05ChaRles09/RV32I-5Stage-Pipeline-CPU/docs/IP_PACKAGING_LESSONS.md

# IP 打包踩雷紀錄（Vivado 2022.2）

| 症狀 | 原因 | 解法 |
|---|---|---|
| module not found / 檔案找不到 | `component.xml` 的路徑指向 `../src` | 改為 IP 內的 `hdl/` 相對路徑 |
| 檔案被當成 Verilog Header | `.v` 項目帶有 `isIncludeFile` | 移除該屬性後 Re-Package |
| 重複模組 / 舊程式被用到 | edit project 的 `imports` 有舊副本、舊 repository 路徑 | 刪除舊 imports 與舊 IP repo 路徑，重新 Refresh |
| Customization Parameters / Addressing 是空的 | 打包時頂層參數沒被辨識 | 頂層選對、Merge changes 後重新辨識 |
| `C_S00_AXI_ADDR_WIDTH = 4` | 預設值未改 | 設為 6（暫存器到 0x2C） |
| Merge changes 無限循環（19-377） | 重複檔案／參數不一致 | 清乾淨資料夾重打包 |
| 改了 RTL 卻沒生效 | OOC synthesis / ipshared 快取 | Reset output products → Generate（Global） |
| 板上讀值全 0 / Overlay 不符 | `.bit` 與 `.hwh` 不成對，或 kernel 沒重啟 | 同一次 build 的檔案、重啟 kernel |
| BD 嚴重警告 BD 41-759（`*_bram_dout` 未連接） | CPU IP 的 BRAM 介面沒有接到 BMG | 把 `IMEM_BRAM`／`DMEM_BRAM` 接到 BMG 的 `BRAM_PORTB` |
| BD 41-237（`MASTER_TYPE` 不一致） | BMG 在 BRAM Controller 模式，介面型別是 `BRAM_CTRL`，自訂 IP 的介面是 `OTHER` | 提示性警告，不影響功能；不值得為此重新打包 |
| BMG 的 Load Init File 灰色、Write Depth 改不動 | BRAM Controller 模式下初始化檔被鎖住、深度由 controller 位址範圍推導 | 需要 COE 或固定深度時改用 Stand Alone 模式 |
| 修改 BMG 後 Address Editor 的位址被重設 | Validate／重新產生時 Vivado 會重新分配位址 | 重設位址後用 Tcl 檢查 `get_bd_addr_segs` |
| PS 批次寫入 IMEM 後 word 0 被改掉 | BMG 的 Enable Port Type 設成 Always Enabled，ENA 腳位消失 | 改成 Use ENA Pin／Use ENB Pin（見開發紀錄 Bug 11） |
