05ChaRles09/RV32I-5Stage-Pipeline-CPU/RV32I Five-Stage Pipelined CPU｜專題成果.pdf

# Five-Stage Pipelined CPU

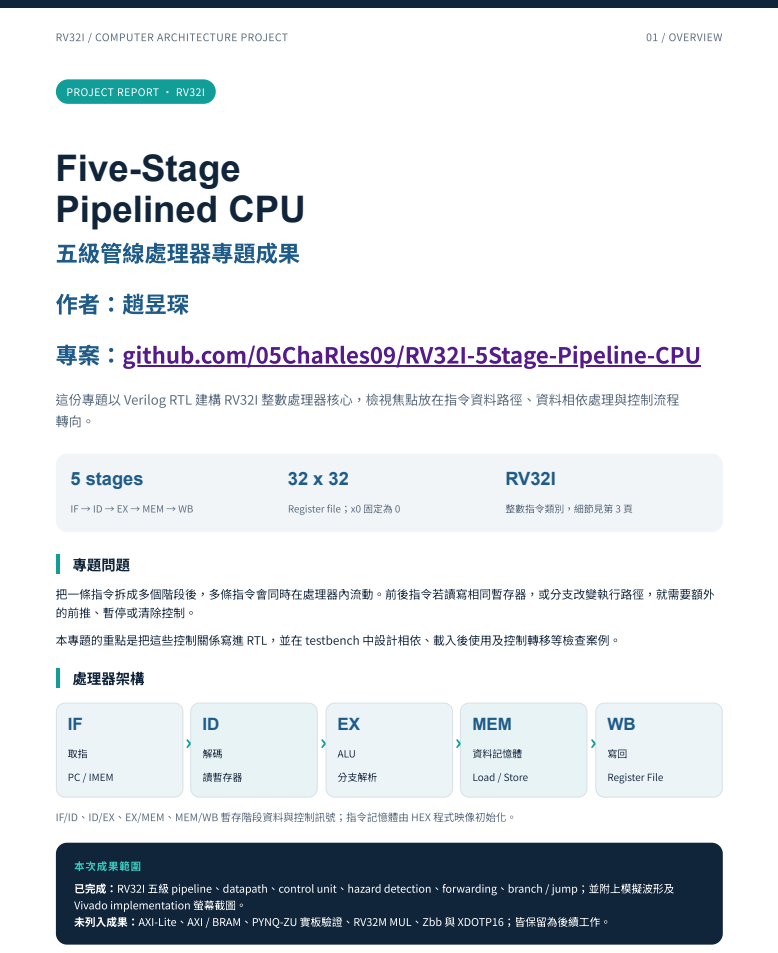
[picture p13: page 1]
PROJECT REPORT · RV32I; 五級管線處理器專題成果; 作者：趙昱琛; 5 stages; 整數指令類別，細節見第 3 頁; 專題問題; 處理器架構; RV32I / COMPUTER ARCHITECTURE PROJECT; 01 / OVERVIEW; PC / IMEM; 讀暫存器; ALU; 分支解析; MEM; 資料記憶體; Load / Store; Register File

專案：github.com/05ChaRles09/RV32I-5Stage-Pipeline-CPU

這份專題以 Verilog RTL 建構 RV32I 整數處理器核心，檢視焦點放在指令資料路徑、資料相依處理與控制流程

IF → ID → EX → MEM → WB

Register file；x0 固定為 0

把一條指令拆成多個階段後，多條指令會同時在處理器內流動。前後指令若讀寫相同暫存器，或分支改變執行路徑，就需要額外
的前推、暫停或清除控制。

本專題的重點是把這些控制關係寫進 RTL，並在 testbench 中設計相依、載入後使用及控制轉移等檢查案例。

IF/ID、ID/EX、EX/MEM、MEM/WB 暫存階段資料與控制訊號；指令記憶體由 HEX 程式映像初始化。

本次成果範圍
已完成：RV32I 五級 pipeline、datapath、control unit、hazard detection、forwarding、branch / jump；並附上模擬波形及
Vivado implementation 螢幕截圖。
未列入成果：AXI-Lite、AXI / BRAM、PYNQ-ZU 實板驗證、RV32M MUL、Zbb 與 XDOTP16；皆保留為後續工作。

# 資料流與冒險處理

IF

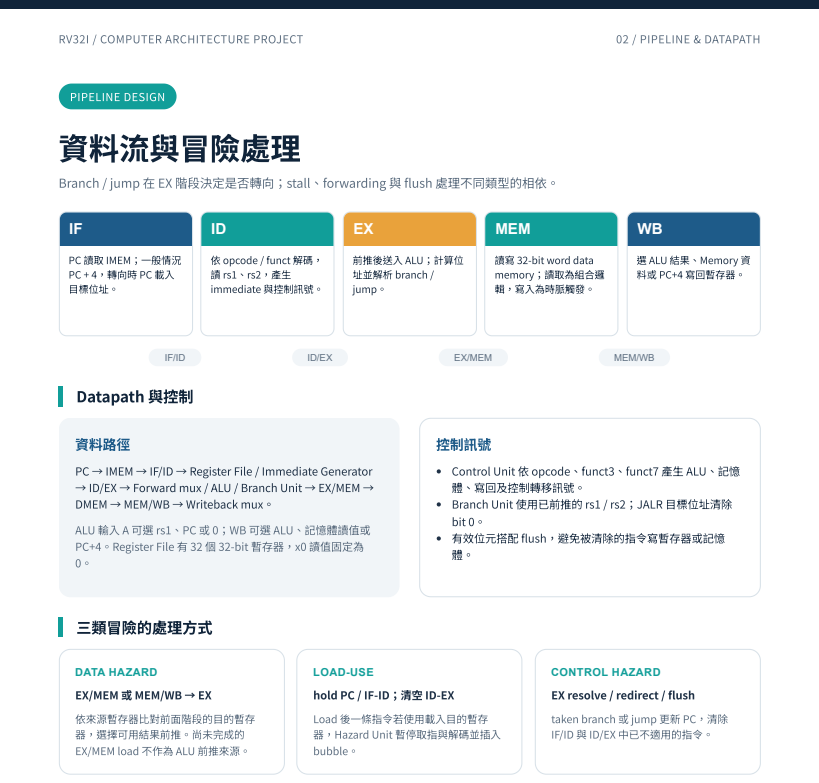
[picture p14: page 2]
PIPELINE DESIGN; MEM; EX/MEM; MEM/WB; Datapath 與控制; 資料路徑; 控制訊號; 三類冒險的處理方式; DATA HAZARD; LOAD-USE; CONTROL HAZARD; RV32I / COMPUTER ARCHITECTURE PROJECT; 02 / PIPELINE & DATAPATH

Branch / jump 在 EX 階段決定是否轉向；stall、forwarding 與 flush 處理不同類型的相依。

PC 讀取 IMEM；一般情況
PC + 4，轉向時 PC 載入
目標位址。

依 opcode / funct 解碼，
immediate 與控制訊號。

前推後送入 ALU；計算位
址並解析 branch /
jump。

讀寫 32-bit word data
memory；讀取為組合邏
輯，寫入為時脈觸發。

選 ALU 結果、Memory 資
料或 PC+4 寫回暫存器。

PC → IMEM → IF/ID → Register File / Immediate Generator
→ ID/EX → Forward mux / ALU / Branch Unit → EX/MEM →
DMEM → MEM/WB → Writeback mux。

Control Unit 依 opcode、funct3、funct7 產生 ALU、記憶
體、寫回及控制轉移訊號。
Branch Unit 使用已前推的 rs1 / rs2；JALR 目標位址清除
bit 0。
有效位元搭配 flush，避免被清除的指令寫暫存器或記憶

ALU 輸入 A 可選 rs1、PC 或 0；WB 可選 ALU、記憶體讀值或
PC+4。Register File 有 32 個 32-bit 暫存器，x0 讀值固定為

EX/MEM 或 MEM/WB → EX

hold PC / IF-ID；清空 ID-EX

EX resolve / redirect / flush

依來源暫存器比對前面階段的目的暫存
器，選擇可用結果前推。尚未完成的
EX/MEM load 不作為 ALU 前推來源。

Load 後一條指令若使用載入目的暫存
器，Hazard Unit 暫停取指與解碼並插入
bubble。

taken branch 或 jump 更新 PC，清除
IF/ID 與 ID/EX 中已不適用的指令。

RTL IMPLEMENTATION

# 實作範圍與測試設計

### RTL 可辨識的指令運算

指令類別 | RTL 中的解碼 / 運算 | 測試覆蓋狀況
R-type | ADD、SUB、AND、OR、XOR、SLL、SRL、SRA、SLT、SLTU | 主 testbench 有部分算術與相依案例
I-type ALU | ADDI、ANDI、ORI、XORI、SLLI、SRLI、SRAI、SLTI、SLTIU | opcode / funct 解碼寫於 Control Unit
Branch | BEQ、BNE、BLT、BGE、BLTU、BGEU | 另有 signed / unsigned branch 案例
Jump | JAL、JALR；link 資料為 PC+4 | 主 testbench 與 JALR 專用 testbench
Upper immediate | LUI、AUIPC | LUI 在主 testbench；AUIPC 在分支測試
Load / Store | opcode 層級 load/store；DMEM 以 32-bit word 索引 | 未見 byte / halfword lane、sign extension 選擇或 misalignment handling

## RTL 模組

rv32i_pipeline.v | 頂層 pipeline、PC 更新、stall / flush 接線與輸出觀察點。
control_unit / alu / imm_gen | opcode 控制、整數 ALU 與立即值產生。
forwarding / hazard / branch units | 運算元前推、load-use 偵測、分支及跳躍解析。
pipeline regs / regfile / memories | 階段暫存器、register file、HEX 指令記憶體與 word data memory。

## Testbench 設定的檢查案例

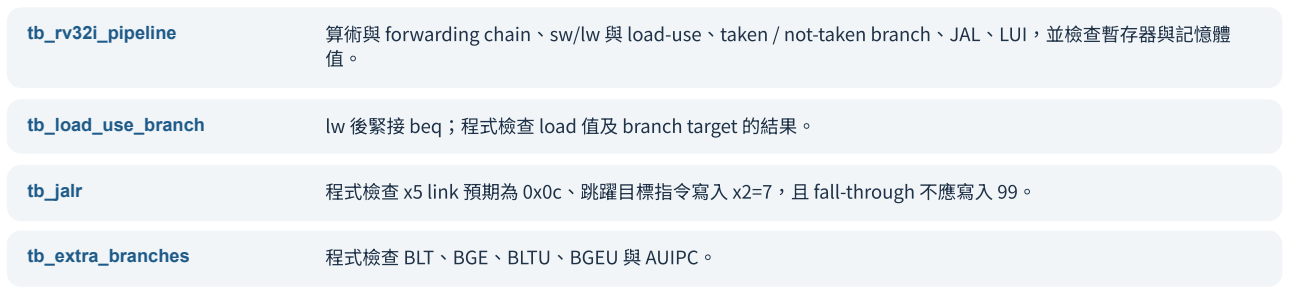
[picture p15: figure]
tb_extra_branches; 程式檢查 BLT、BGE、BLTU、BGEU 與 AUIPC。

tb_rv32i_pipeline | 算術與 forwarding chain、sw/lw 與 load-use、taken / not-taken branch、JAL、LUI，並檢查暫存器與記憶體
tb_load_use_branch | lw 後緊接 beq；程式檢查 load 值及 branch target 的結果。
tb_jalr | 程式檢查 x5 link 預期為 0x0c、跳躍目標指令寫入 x2=7，且 fall-through 不應寫入 99。
RV32I / COMPUTER ARCHITECTURE PROJECT | 03 / RTL & VERIFICATION

# 管線控制的波形 I

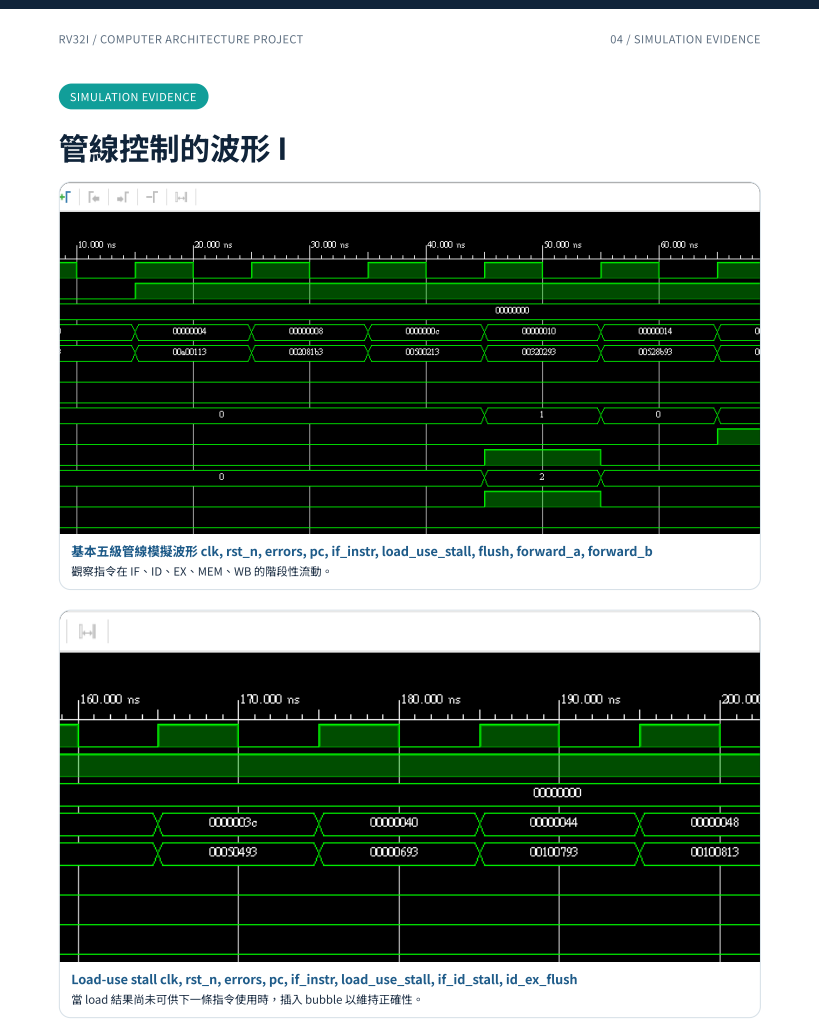
[picture p16: page 4]
SIMULATION EVIDENCE; RV32I / COMPUTER ARCHITECTURE PROJECT; 04 / SIMULATION EVIDENCE

基本五級管線模擬波形 clk, rst_n, errors, pc, if_instr, load_use_stall, flush, forward_a, forward_b
觀察指令在 IF、ID、EX、MEM、WB 的階段性流動。

Load-use stall clk, rst_n, errors, pc, if_instr, load_use_stall, if_id_stall, id_ex_flush
當 load 結果尚未可供下一條指令使用時，插入 bubble 以維持正確性。

# 管線控制的波形 II

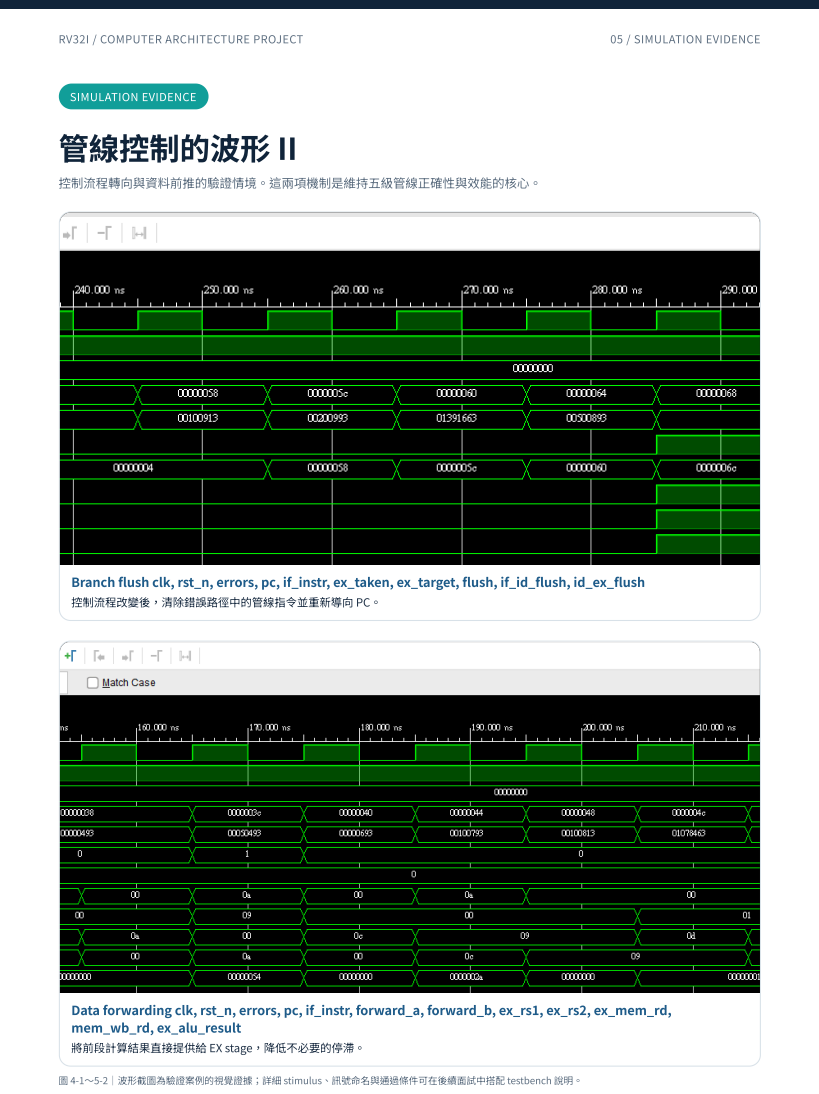
[picture p17: page 5]
SIMULATION EVIDENCE; 控制流程轉向與資料前推的驗證情境。這兩項機制是維持五級管線正確性與效能的核心。; RV32I / COMPUTER ARCHITECTURE PROJECT; 05 / SIMULATION EVIDENCE

Branch flush clk, rst_n, errors, pc, if_instr, ex_taken, ex_target, flush, if_id_flush, id_ex_flush
控制流程改變後，清除錯誤路徑中的管線指令並重新導向 PC。

Data forwarding clk, rst_n, errors, pc, if_instr, forward_a, forward_b, ex_rs1, ex_rs2, ex_mem_rd,
mem_wb_rd, ex_alu_result
將前段計算結果直接提供給 EX stage，降低不必要的停滯。

圖 4-1～5-2｜波形截圖為驗證案例的視覺證據；詳細 stimulus、訊號命名與通過條件可在後續面試中搭配 testbench 說明。

# FPGA 實作結果與延伸方向

4.560 ns

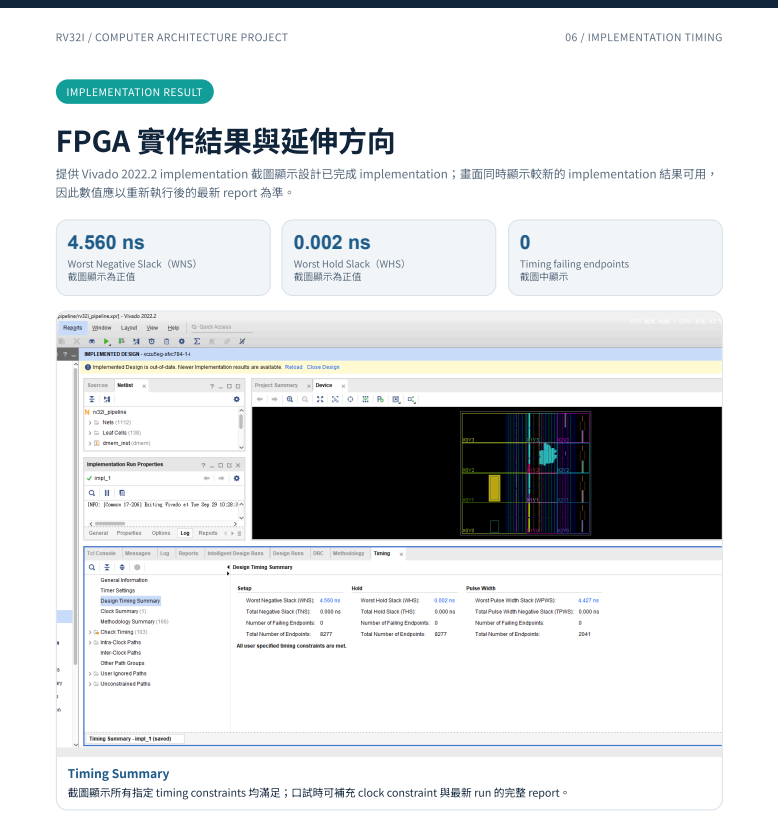
[picture p18: page 6]
IMPLEMENTATION RESULT; RV32I / COMPUTER ARCHITECTURE PROJECT; 06 / IMPLEMENTATION TIMING

提供 Vivado 2022.2 implementation 截圖顯示設計已完成 implementation；畫面同時顯示較新的 implementation 結果可用，
因此數值應以重新執行後的最新 report 為準。

Worst Negative Slack（WNS）
截圖顯示為正值

Worst Hold Slack（WHS）

Timing failing endpoints
截圖中顯示

Timing Summary
截圖顯示所有指定 timing constraints 均滿足；口試時可補充 clock constraint 與最新 run 的完整 report。

# 資源使用與延伸方向

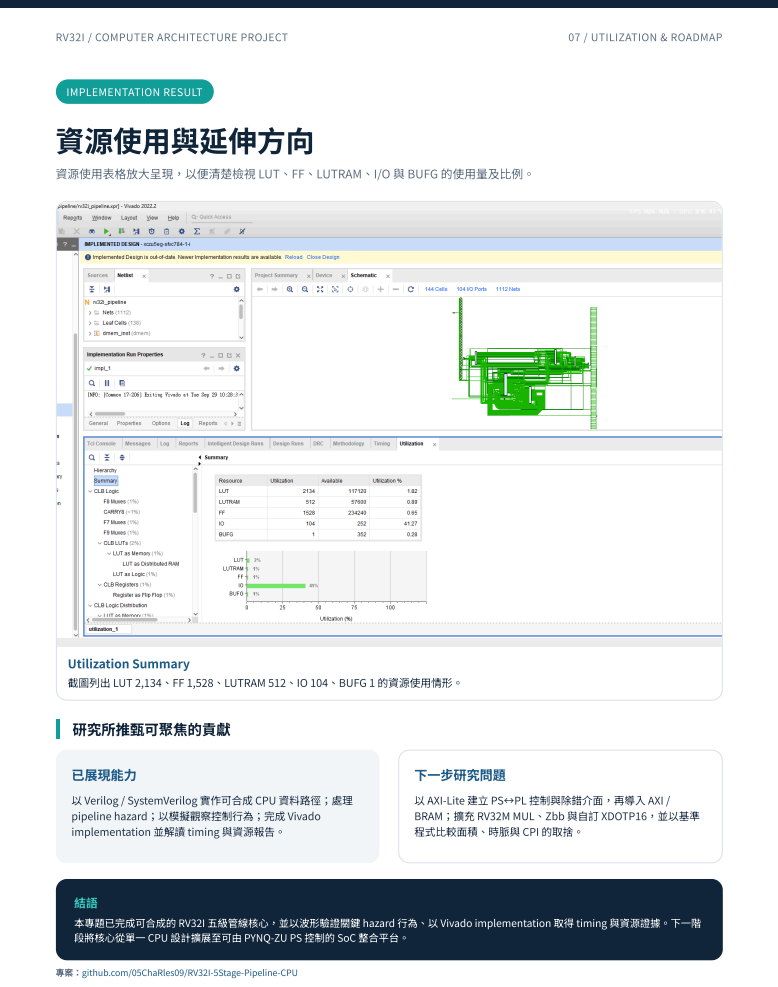
[picture p19: page 7]
IMPLEMENTATION RESULT; 研究所推甄可聚焦的貢獻; 已展現能力; 下一步研究問題; 段將核心從單一; CPU 設計擴展至可由 PYNQ-ZU PS 控制的 SoC 整合平台。; RV32I / COMPUTER ARCHITECTURE PROJECT; 07 / UTILIZATION & ROADMAP

資源使用表格放大呈現，以便清楚檢視 LUT、FF、LUTRAM、I/O 與 BUFG 的使用量及比例。

Utilization Summary
截圖列出 LUT 2,134、FF 1,528、LUTRAM 512、IO 104、BUFG 1 的資源使用情形。

以 Verilog / SystemVerilog 實作可合成 CPU 資料路徑；處理
pipeline hazard；以模擬觀察控制行為；完成 Vivado
implementation 並解讀 timing 與資源報告。

以 AXI-Lite 建立 PS↔PL 控制與除錯介面，再導入 AXI /
BRAM；擴充 RV32M MUL、Zbb 與自訂 XDOTP16，並以基準
程式比較面積、時脈與 CPI 的取捨。

本專題已完成可合成的 RV32I 五級管線核心，並以波形驗證關鍵 hazard 行為、以 Vivado implementation 取得 timing 與資源證據。下一階

專案：github.com/05ChaRles09/RV32I-5Stage-Pipeline-CPU
