05ChaRles09/RV32I-5Stage-Pipeline-CPU/src/imem.v

// imem.v instruction memory (BRAM-style): SYNCHRONOUS read, 1-cycle latency. Drive addr with pc_next so
// that instr is valid in the same cycle as the pc register (see rv32i_pipeline.v IF stage).
`timescale 1ns / 1ps

module imem #(
    parameter ADDR_WIDTH = 12,
    parameter MEM_FILE    = "program.hex",
    parameter EXTERNAL    = 0      // 1: instruction memory lives OUTSIDE (Block Memory Generator); ext_rdata is used
)(
    input  wire        clk,
    input  wire [31:0] addr,           // address of the instruction to appear on instr NEXT cycle
    output wire [31:0] instr,
    input  wire [31:0] ext_rdata       // read data of the external BRAM (only used when EXTERNAL=1)
);
    localparam DEPTH = (1 << ADDR_WIDTH);
    reg [31:0] mem [0:DEPTH-1];
    integer i;

    initial begin
        // Hardcoded default program (136 words) = board test program (RV32I + Zbb + MUL + XDOTP16 + illegal), generated by tools/gen_board_test.py.
        // This guarantees imem output is NON-CONSTANT even when the hex
        // file is absent (e.g. standalone Vivado synthesis where the run
        // directory has no program.hex) otherwise Vivado constant-folds
        // the whole ROM away and prunes the entire pipeline.
        // If $readmemh finds MEM_FILE, it overrides these values.
        for (i = 0; i < DEPTH; i = i + 1)
            mem[i] = 32'h00000013; // NOP fill FIRST, then the program words below overwrite it

        mem[0] = 32'h00500093;
        mem[1] = 32'h00a00113;
        mem[2] = 32'h002081b3;
        mem[3] = 32'h00500213;
        mem[4] = 32'h00320293;
        mem[5] = 32'h00528b93;
        mem[6] = 32'h00100313;
        mem[7] = 32'h00130393;
        mem[8] = 32'h00138413;
        mem[9] = 32'h00000593;
        mem[10] = 32'h02a00493;
        mem[11] = 32'h0095a023;
        mem[12] = 32'h0005a503;
        mem[13] = 32'h00950633;
        mem[14] = 32'h00000493;
        mem[15] = 32'h00050493;
        mem[16] = 32'h00000693;
        mem[17] = 32'h00100793;
        mem[18] = 32'h00100813;
        mem[19] = 32'h01078463;
        mem[20] = 32'h06300693;
        mem[21] = 32'h00700713;
        mem[22] = 32'h00100913;
        mem[23] = 32'h00200993;
        mem[24] = 32'h01391663;
        mem[25] = 32'h00500893;
        mem[26] = 32'h00900893;
        mem[27] = 32'h00900893;
        mem[28] = 32'h00000013;
        mem[29] = 32'h00000013;
        mem[30] = 32'h00000a93;
        mem[31] = 32'h00c000ef;
        mem[32] = 32'h00500a93;
        mem[33] = 32'h00700a93;
        mem[34] = 32'h06300a13;
        mem[35] = 32'h0080006f;
        mem[36] = 32'h00500a93;
        mem[37] = 32'h12345b37;
        mem[38] = 32'h0040006f;
        mem[39] = 32'hf0f090b7;
        mem[40] = 32'ha8108093;
        mem[41] = 32'h00ff0137;
        mem[42] = 32'h00310113;
        mem[43] = 32'h000121b7;
        mem[44] = 32'h30018193;
        mem[45] = 32'h4020f2b3;
        mem[46] = 32'h4020e333;
        mem[47] = 32'h4020c3b3;
        mem[48] = 32'h0a20c433;
        mem[49] = 32'h0a20d4b3;
        mem[50] = 32'h0a20e533;
        mem[51] = 32'h0a20f5b3;
        mem[52] = 32'h60209633;
        mem[53] = 32'h6020d6b3;
        mem[54] = 32'h60c0d713;
        mem[55] = 32'h60019793;
        mem[56] = 32'h60119813;
        mem[57] = 32'h60209893;
        mem[58] = 32'h60409913;
        mem[59] = 32'h60509993;
        mem[60] = 32'h0800ca33;
        mem[61] = 32'h6980da93;
        mem[62] = 32'h2871db13;
        mem[63] = 32'h60001b93;
        mem[64] = 32'h60101c13;
        mem[65] = 32'h60201c93;
        mem[66] = 32'h60009d13;
        mem[67] = 32'h60109d93;
        mem[68] = 32'h60019e13;
        mem[69] = 32'h01ce0eb3;
        mem[70] = 32'h6980df13;
        mem[71] = 32'h001f4fb3;
        mem[72] = 32'h01502423;
        mem[73] = 32'h00802283;
        mem[74] = 32'h00528333;
        mem[75] = 32'h60219393;
        mem[76] = 32'h00400413;
        mem[77] = 32'h00839463;
        mem[78] = 32'h05500493;
        mem[79] = 32'h00838463;
        mem[80] = 32'h02a50533;
        mem[81] = 32'h06600513;
        mem[82] = 32'h022087b3;
        mem[83] = 32'h02108833;
        mem[84] = 32'h020188b3;
        mem[85] = 32'hfff00993;
        mem[86] = 32'h03398a33;
        mem[87] = 32'h02398ab3;
        mem[88] = 32'h80000e37;
        mem[89] = 32'h00200e93;
        mem[90] = 32'h03de0f33;
        mem[91] = 32'h033e0fb3;
        mem[92] = 32'h02208b33;
        mem[93] = 32'h016b0bb3;
        mem[94] = 32'h036b0c33;
        mem[95] = 32'h01602623;
        mem[96] = 32'h00c02c83;
        mem[97] = 32'h023c8d33;
        mem[98] = 32'h03de83b3;
        mem[99] = 32'h00400413;
        mem[100] = 32'h00839463;
        mem[101] = 32'h03c00493;
        mem[102] = 32'h00838463;
        mem[103] = 32'h03de8db3;
        mem[104] = 32'h02b00513;
        mem[105] = 32'h0020878b;
        mem[106] = 32'h0010880b;
        mem[107] = 32'h0001888b;
        mem[108] = 32'h80008e37;
        mem[109] = 32'h01ce0e8b;
        mem[110] = 32'h7fff89b7;
        mem[111] = 32'hfff98993;
        mem[112] = 32'h01398a0b;
        mem[113] = 32'h013e0a8b;
        mem[114] = 32'h00208b0b;
        mem[115] = 32'h016b0bb3;
        mem[116] = 32'h016b0c0b;
        mem[117] = 32'h01602823;
        mem[118] = 32'h01002c83;
        mem[119] = 32'h001c8d0b;
        mem[120] = 32'h0000038b;
        mem[121] = 32'h00000413;
        mem[122] = 32'h00838463;
        mem[123] = 32'h00208d8b;
        mem[124] = 32'h07700513;
        mem[125] = 32'h02a59633;
        mem[126] = 32'h0220860b;
        mem[127] = 32'h00000283;
        mem[128] = 32'h00000000;
        mem[129] = 32'h0ff0000f;
        mem[130] = 32'h00000073;
        mem[131] = 32'h00100023;
        mem[132] = 32'h40109593;
        mem[133] = 32'h60309693;
        mem[134] = 32'h07a00713;
        mem[135] = 32'h0000006f;
        $readmemh(MEM_FILE, mem);
        $display("IMEM: successfully loaded file '%0s'", MEM_FILE);
        $display("IMEM: mem[0] = %08h", mem[0]);
    end

    // synchronous read (read latency 1, like a BMG with its output register disabled)
    // In EXTERNAL mode this array is never read and is optimised away; the program lives in the BMG (COE file / PS).
    reg [31:0] mem_q;
    always @(posedge clk)
        mem_q <= mem[addr[ADDR_WIDTH-1:2]];
    assign instr = EXTERNAL ? ext_rdata : mem_q;
endmodule
