05ChaRles09/RV32I-5Stage-Pipeline-CPU/axi/rv32i_pipelined_cpu_v1_0.v

`timescale 1 ns / 1 ps

	module rv32i_pipelined_cpu_v1_0 #
	(
		// Users to add parameters here
		parameter EXTERNAL_MEM = 1,
		// User parameters ends
		// Do not modify the parameters beyond this line


		// Parameters of Axi Slave Bus Interface S00_AXI
		parameter integer C_S00_AXI_DATA_WIDTH	= 32,
		parameter integer C_S00_AXI_ADDR_WIDTH	= 6
	)
	(
		// Users to add ports here
		output wire [31:0] imem_bram_addr,
		output wire        imem_bram_clk,
		output wire        imem_bram_rst,
		output wire        imem_bram_en,
		output wire [3:0]  imem_bram_we,
		output wire [31:0] imem_bram_din,
		input  wire [31:0] imem_bram_dout,
		output wire [31:0] dmem_bram_addr,
		output wire        dmem_bram_clk,
		output wire        dmem_bram_rst,
		output wire        dmem_bram_en,
		output wire [3:0]  dmem_bram_we,
		output wire [31:0] dmem_bram_din,
		input  wire [31:0] dmem_bram_dout,

		// User ports ends
		// Do not modify the ports beyond this line


		// Ports of Axi Slave Bus Interface S00_AXI
		input wire  s00_axi_aclk,
		input wire  s00_axi_aresetn,
		input wire [C_S00_AXI_ADDR_WIDTH-1 : 0] s00_axi_awaddr,
		input wire [2 : 0] s00_axi_awprot,
		input wire  s00_axi_awvalid,
		output wire  s00_axi_awready,
		input wire [C_S00_AXI_DATA_WIDTH-1 : 0] s00_axi_wdata,
		input wire [(C_S00_AXI_DATA_WIDTH/8)-1 : 0] s00_axi_wstrb,
		input wire  s00_axi_wvalid,
		output wire  s00_axi_wready,
		output wire [1 : 0] s00_axi_bresp,
		output wire  s00_axi_bvalid,
		input wire  s00_axi_bready,
		input wire [C_S00_AXI_ADDR_WIDTH-1 : 0] s00_axi_araddr,
		input wire [2 : 0] s00_axi_arprot,
		input wire  s00_axi_arvalid,
		output wire  s00_axi_arready,
		output wire [C_S00_AXI_DATA_WIDTH-1 : 0] s00_axi_rdata,
		output wire [1 : 0] s00_axi_rresp,
		output wire  s00_axi_rvalid,
		input wire  s00_axi_rready
	);
// Instantiation of Axi Bus Interface S00_AXI
	rv32i_pipelined_cpu_v1_0_S00_AXI # ( 
		.EXTERNAL_MEM(EXTERNAL_MEM),
		.C_S_AXI_DATA_WIDTH(C_S00_AXI_DATA_WIDTH),
		.C_S_AXI_ADDR_WIDTH(C_S00_AXI_ADDR_WIDTH)
	) rv32i_pipelined_cpu_v1_0_S00_AXI_inst (
		.imem_bram_addr(imem_bram_addr),
.imem_bram_clk(imem_bram_clk),
.imem_bram_rst(imem_bram_rst),
.imem_bram_en(imem_bram_en),
.imem_bram_we(imem_bram_we),
.imem_bram_din(imem_bram_din),
.imem_bram_dout(imem_bram_dout),
.dmem_bram_addr(dmem_bram_addr),
.dmem_bram_clk(dmem_bram_clk),
.dmem_bram_rst(dmem_bram_rst),
.dmem_bram_en(dmem_bram_en),
.dmem_bram_we(dmem_bram_we),
.dmem_bram_din(dmem_bram_din),
.dmem_bram_dout(dmem_bram_dout),
		.S_AXI_ACLK(s00_axi_aclk),
		.S_AXI_ARESETN(s00_axi_aresetn),
		.S_AXI_AWADDR(s00_axi_awaddr),
		.S_AXI_AWPROT(s00_axi_awprot),
		.S_AXI_AWVALID(s00_axi_awvalid),
		.S_AXI_AWREADY(s00_axi_awready),
		.S_AXI_WDATA(s00_axi_wdata),
		.S_AXI_WSTRB(s00_axi_wstrb),
		.S_AXI_WVALID(s00_axi_wvalid),
		.S_AXI_WREADY(s00_axi_wready),
		.S_AXI_BRESP(s00_axi_bresp),
		.S_AXI_BVALID(s00_axi_bvalid),
		.S_AXI_BREADY(s00_axi_bready),
		.S_AXI_ARADDR(s00_axi_araddr),
		.S_AXI_ARPROT(s00_axi_arprot),
		.S_AXI_ARVALID(s00_axi_arvalid),
		.S_AXI_ARREADY(s00_axi_arready),
		.S_AXI_RDATA(s00_axi_rdata),
		.S_AXI_RRESP(s00_axi_rresp),
		.S_AXI_RVALID(s00_axi_rvalid),
		.S_AXI_RREADY(s00_axi_rready)
	);

	// Add user logic here

	// User logic ends

	endmodule
