05ChaRles09/RV32I-5Stage-Pipeline-CPU/src/if_id_reg.v

// if_id_reg.v
`timescale 1ns / 1ps

module if_id_reg (
    input  wire        clk,
    input  wire        rst_n,
    input  wire        stall,
    input  wire        flush,

    input  wire [31:0] pc_in,
    input  wire [31:0] pc_plus4_in,
    input  wire [31:0] instr_in,
    input  wire        valid_in,

    output reg  [31:0] pc_out,
    output reg  [31:0] pc_plus4_out,
    output reg  [31:0] instr_out,
    output reg         valid_out
);
    localparam NOP = 32'h00000013;

    always @(posedge clk or negedge rst_n) begin
        if (!rst_n) begin
            pc_out       <= 32'b0;
            pc_plus4_out <= 32'b0;
            instr_out    <= NOP;
            valid_out    <= 1'b0;
        end else if (flush) begin
            pc_out       <= 32'b0;
            pc_plus4_out <= 32'b0;
            instr_out    <= NOP;
            valid_out    <= 1'b0;
        end else if (stall) begin
            pc_out       <= pc_out;
            pc_plus4_out <= pc_plus4_out;
            instr_out    <= instr_out;
            valid_out    <= valid_out;
        end else begin
            pc_out       <= pc_in;
            pc_plus4_out <= pc_plus4_in;
            instr_out    <= instr_in;
            valid_out    <= valid_in;
        end
    end
endmodule
