05ChaRles09/RV32I-5Stage-Pipeline-CPU/src/imm_gen.v

// imm_gen.v immediate generator for all RV32I formats
`timescale 1ns / 1ps

module imm_gen (
    input  wire [31:0] instr,
    output reg  [31:0] imm
);
    wire [6:0] opcode = instr[6:0];
    wire [4:0] imm11_7  = instr[31:7];

    always @(*) begin
        case (opcode)
            // R-type: no immediate (but provide 0 for safety)
            7'b0110011: imm = 32'b0;
            // I-type
            7'b0010011, 7'b0000011, 7'b1100111:
                imm = {{20{instr[31]}}, instr[31:20]};
            // S-type
            7'b0100011:
                imm = {{20{instr[31]}}, instr[31:25], instr[11:7]};
            // B-type
            7'b1100011:
                imm = {{19{instr[31]}}, instr[31], instr[7],
                       instr[30:25], instr[11:8], 1'b0};
            // U-type
            7'b0110111, 7'b0010111:
                imm = {instr[31:12], 12'b0};
            // J-type
            7'b1101111:
                imm = {{11{instr[31]}}, instr[31], instr[19:12],
                       instr[20], instr[30:21], 1'b0};
            default: imm = 32'b0;
        endcase
    end
endmodule
