05ChaRles09/RV32I-5Stage-Pipeline-CPU/(commit log)

2026-09-30 RV32I Five-Stage Pipelined CPU｜專題成果(階段性)2026.10.01
2026-10-04 RV32I Five-Stage Pipelined CPU｜專題成果.pdf 2026.10.04
2026-10-04 Screenshots_RV32I.zip
    RV32I Five-Stage Pipelined CPU｜專題成果之數據
2026-10-05 Update README
    Removed statement about AXI-Lite integration not being confirmed on PYNQ-ZU board.
2026-10-10 docs: 新增 PYNQ-ZU 上板測試腳本、硬體燒錄檔與 ALL PASS 測試報告
2026-10-10 Revise README with project updates and clarifications
    Updated README to reflect changes in project details and testing results, including improved descriptions of pipeline stages, components, and verification status.
2026-10-14 ADD XDOTP16, fix imem.v, docs: add XDOTP16 board report (40/40 PASS), update README, add development log
2026-10-15 Update README with Stage 1 and Stage 2 tasks
2026-10-17 Phase 4 Stage 2b (IP 1.6): BMG + AXI BRAM Controller, Notebook v5 52/52 PASS
    - CPU IP exposes IMEM/DMEM BRAM master ports; imem/dmem as Block Memory Generator
    - PS loads/reads IMEM and DMEM through AXI BRAM Controller
    - Add Vivado util/timing/power reports for IP 1.5 and 1.6
    - Rewrite PHASE4_STAGE2B_VIVADO.md; update README and dev log (Bug 11-13)
2026-10-17 Update README to include project report materials
    Added project report materials to the documentation section.
2026-10-20 Add riscv-arch-test flow: 51/51 supported tests pass (simulation)
